dtilchin/PossumCtrl/hardware/ableton controller.kicad_pcb

## KiCad design hardware/ableton controller.kicad_pcb (2021-08-29)

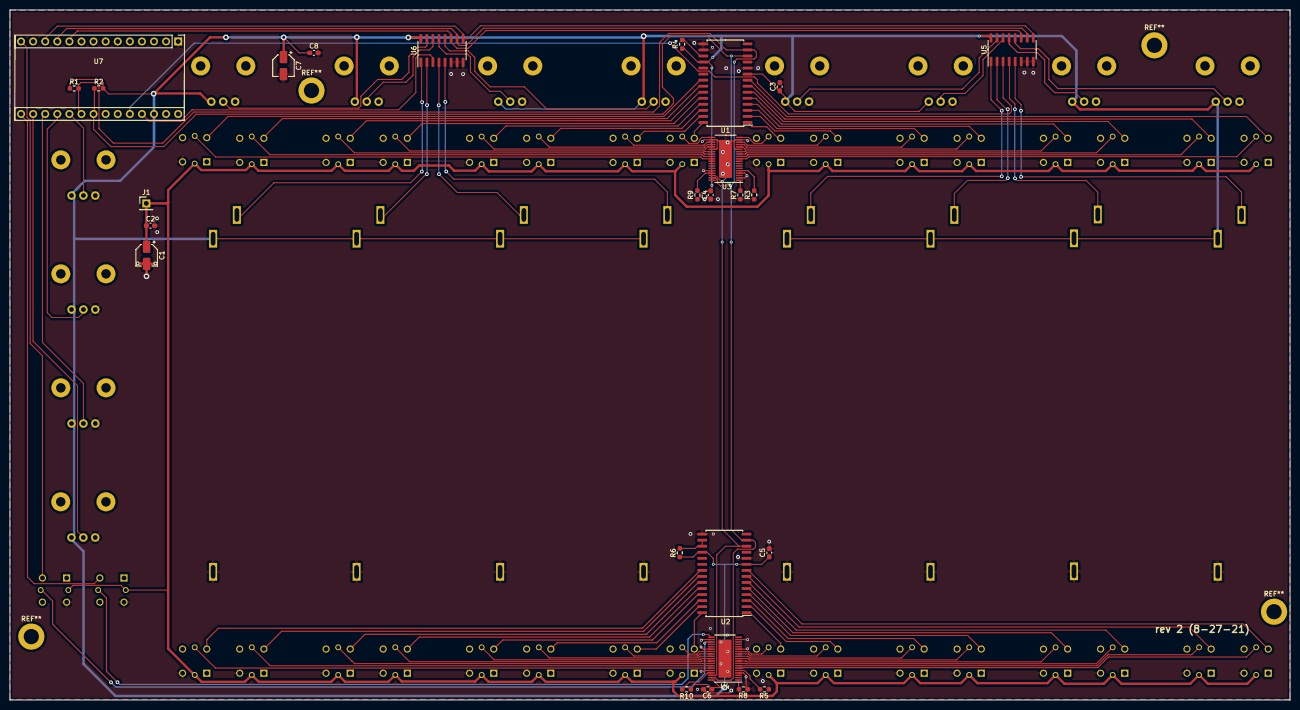
[picture p1: board ableton controller.kicad_pcb from above]

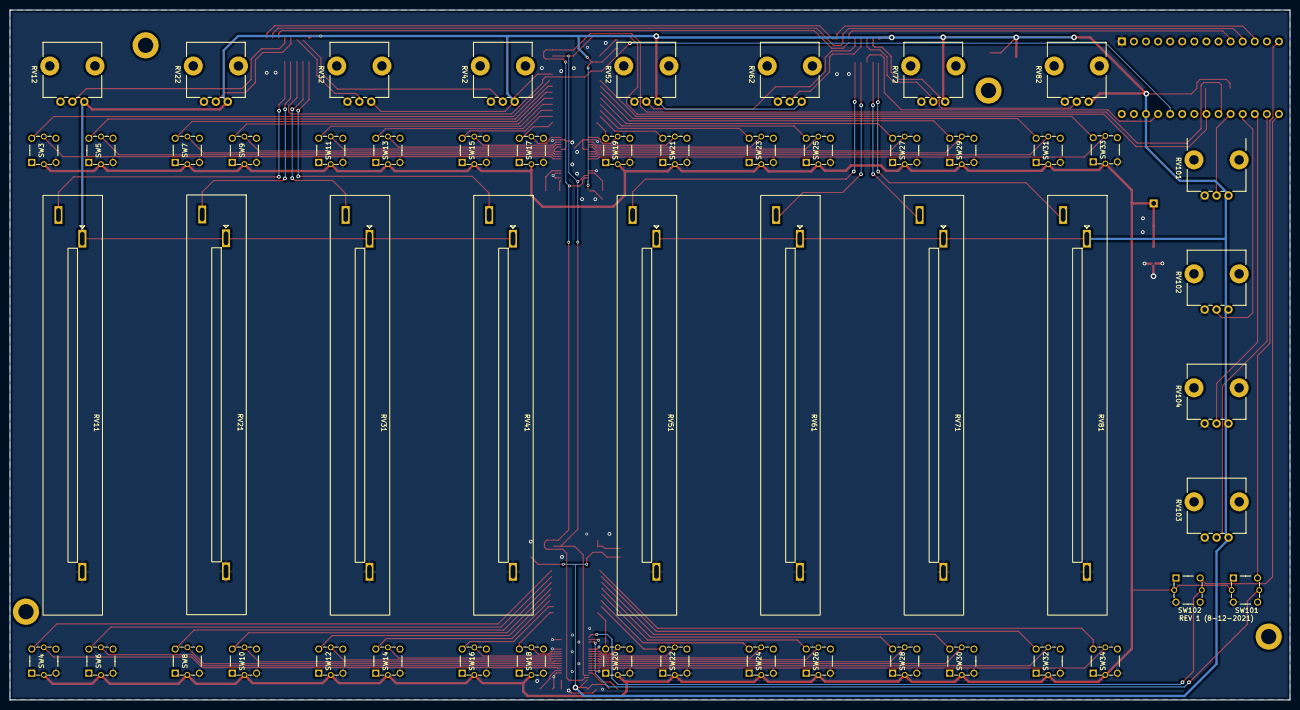
[picture p2: board ableton controller.kicad_pcb from below]

Board: 2 copper layers, 269.0 x 145.0 mm, 80 parts (54 on the bottom side), 106 nets.

Parts:
C1, C7: 10u; CP_Elec_4x4.5
C2, C3, C4, C5, C6, C8: 100n; C_0603_1608Metric_Pad1.08x0.95mm_HandSolder
J1: USB_header; PinHeader_1x01_P2.54mm_Vertical
R1, R2: 2k; R_0603_1608Metric_Pad0.98x0.95mm_HandSolder
R3, R4, R5, R6, R9, R10: 10k; R_0603_1608Metric_Pad0.98x0.95mm_HandSolder
R7, R8: 1k; R_0603_1608Metric_Pad0.98x0.95mm_HandSolder
RV11, RV21, RV31, RV41, RV51, RV61, RV71, RV81: R_gain; pot_slide_alpha_RA6020F
RV12, RV22, RV32, RV42, RV52, RV62, RV72, RV82: R_fx; Potentiometer_TaydaRV9312_Alpha901F_AlpsRK09L
RV101: R_fx_1; Potentiometer_TaydaRV9312_Alpha901F_AlpsRK09L
RV102: R_fx_2; Potentiometer_TaydaRV9312_Alpha901F_AlpsRK09L
RV103: R_fx_3; Potentiometer_TaydaRV9312_Alpha901F_AlpsRK09L
RV104: R_fx_4; Potentiometer_TaydaRV9312_Alpha901F_AlpsRK09L
SW3, SW7, SW11, SW15, SW19, SW23, SW27, SW31: SW_mute; Switch_button_LED_SPST_TS5_9.2mm
SW4, SW8, SW12, SW16, SW20, SW24, SW28, SW32: SW_play; Switch_button_LED_SPST_TS5_9.2mm
SW5, SW9, SW13, SW17, SW21, SW25, SW29, SW33: SW_solo; Switch_button_LED_SPST_TS5_9.2mm
SW6, SW10, SW14, SW18, SW22, SW26, SW30, SW34: SW_rec; Switch_button_LED_SPST_TS5_9.2mm
SW101: SW_m_rec; Switch_button_LED_SPST_TS5_9.2mm
SW102: SW_m_play; Switch_button_LED_SPST_TS5_9.2mm
U1, U2: MCP23017_SO; SOIC-28W_7.5x17.9mm_P1.27mm
U3, U4: PCA9956BTWY; TSSOP-38_4.4x9.7mm_P0.5mm_thermal39p
U5, U6: CD4051B; SOIC-16_3.9x9.9mm_P1.27mm
U7: Teensy-LC_sidepins; Teensy40_headers

Connections:
+5V: C1.1, C2.1, J1.1, SW3.6, SW4.6, SW5.6, SW6.6, SW7.6, SW8.6, SW9.6, SW10.6, SW11.6, SW12.6, SW13.6, SW14.6, SW15.6, SW16.6, SW17.6, SW18.6, SW19.6, SW20.6, SW21.6, SW22.6, SW23.6, SW24.6, SW25.6, SW26.6, SW27.6, SW28.6, SW29.6, SW30.6, SW31.6, SW32.6, SW33.6, SW34.6, SW101.6, SW102.6
/ADC0: U5.3 (X), U7.24 (22_A8_SCL1_PWM_Touch)
/ADC1: U6.3 (X), U7.25 (23_A9_SDA1_PWM_Touch)
/LED_MUTE_1: SW3.5, U3.10 (LED4)
/LED_MUTE_2: SW7.5, U3.12 (LED6)
/LED_MUTE_3: SW11.5, U3.15 (LED8)
/LED_MUTE_4: SW15.5, U3.17 (LED10)
/LED_MUTE_5: SW19.5, U3.20 (LED12)
/LED_MUTE_6: SW23.5, U3.23 (LED14)
/LED_MUTE_7: SW27.5, U3.26 (LED16)
/LED_MUTE_8: SW31.5, U3.28 (LED18)
/LED_PLAY: SW102.5, U4.20 (LED12)
/LED_PLAY_1: SW4.5, U4.6 (LED0)
/LED_PLAY_2: SW8.5, U4.8 (LED2)
/LED_PLAY_3: SW12.5, U4.10 (LED4)
/LED_PLAY_4: SW16.5, U4.12 (LED6)
/LED_PLAY_5: SW20.5, U4.26 (LED16)
/LED_PLAY_6: SW24.5, U4.28 (LED18)
/LED_PLAY_7: SW28.5, U4.30 (LED20)
/LED_PLAY_8: SW32.5, U4.32 (LED22)
/LED_REC: SW101.5, U4.22 (LED13)
/LED_REC_1: SW6.5, U4.7 (LED1)
/LED_REC_2: SW10.5, U4.9 (LED3)
/LED_REC_3: SW14.5, U4.11 (LED5)
/LED_REC_4: SW18.5, U4.13 (LED7)
/LED_REC_5: SW22.5, U4.27 (LED17)
/LED_REC_6: SW26.5, U4.29 (LED19)
/LED_REC_7: SW30.5, U4.31 (LED21)
/LED_REC_8: SW34.5, U4.33 (LED23)
/LED_SOLO_1: SW5.5, U3.11 (LED5)
/LED_SOLO_2: SW9.5, U3.13 (LED7)
/LED_SOLO_3: SW13.5, U3.16 (LED9)
/LED_SOLO_4: SW17.5, U3.19 (LED11)
/LED_SOLO_5: SW21.5, U3.22 (LED13)
/LED_SOLO_6: SW25.5, U3.24 (LED15)
/LED_SOLO_7: SW29.5, U3.27 (LED17)
/LED_SOLO_8: SW33.5, U3.29 (LED19)
/MUX_POT_A: U5.11 (A), U6.11 (A), U7.10 (8_TX3_MISO0)
/MUX_POT_B: U5.10 (B), U6.10 (B), U7.11 (9_RX2_PWM)
/MUX_POT_C: U5.9 (C), U6.9 (C), U7.12 (10_TX2_CS0_PWM)
/POT_FX_1: RV101.2, U7.19 (17_A3_SDA0_PWM_Touch)
/POT_FX_2: RV102.2, U7.18 (16_A2_SCL0_PWM_Touch)
/POT_FX_3: RV103.2, U7.16 (14_A0_SCK0)
/POT_FX_4: RV104.2, U7.17 (15_A1_Touch)
/POT_GAIN_1: RV11.2, U5.5 (X5)
/POT_GAIN_2: RV21.2, U5.4 (X7)
/POT_GAIN_3: RV31.2, U5.2 (X6)
/POT_GAIN_4: RV41.2, U5.1 (X4)
/POT_GAIN_5: RV51.2, U6.5 (X5)
/POT_GAIN_6: RV61.2, U6.4 (X7)
/POT_GAIN_7: RV71.2, U6.2 (X6)
/POT_GAIN_8: RV81.2, U6.1 (X4)
/POT_UTIL_1: RV12.2, U5.12 (X3)
/POT_UTIL_2: RV22.2, U5.13 (X0)
/POT_UTIL_3: RV32.2, U5.14 (X1)
/POT_UTIL_4: RV42.2, U5.15 (X2)
/POT_UTIL_5: RV52.2, U6.12 (X3)
/POT_UTIL_6: RV62.2, U6.13 (X0)
/POT_UTIL_7: RV72.2, U6.14 (X1)
/POT_UTIL_8: RV82.2, U6.15 (X2)
/SCL: R2.2, U1.12 (SCK), U2.12 (SCK), U3.36 (SCL), U4.36 (SCL), U7.21 (19_A5_SCL0_Touch)
/SDA: R1.2, U1.13 (SDA), U2.13 (SDA), U3.37 (SDA), U4.37 (SDA), U7.20 (18_A4_SDA0_Touch)
/SW_MUTE_1: SW3.2, U1.8 (GPB7)
/SW_MUTE_2: SW7.2, U1.6 (GPB5)
/SW_MUTE_3: SW11.2, U1.4 (GPB3)
/SW_MUTE_4: SW15.2, U1.2 (GPB1)
/SW_MUTE_5: SW19.2, U1.28 (GPA7)
/SW_MUTE_6: SW23.2, U1.26 (GPA5)
/SW_MUTE_7: SW27.2, U1.24 (GPA3)
/SW_MUTE_8: SW31.2, U1.22 (GPA1)
/SW_PLAY: SW102.2, U7.15 (13_LED_SCK0)
/SW_PLAY_1: SW4.2, U2.8 (GPB7)
/SW_PLAY_2: SW8.2, U2.6 (GPB5)
/SW_PLAY_3: SW12.2, U2.4 (GPB3)
/SW_PLAY_4: SW16.2, U2.2 (GPB1)
/SW_PLAY_5: SW20.2, U2.28 (GPA7)
/SW_PLAY_6: SW24.2, U2.26 (GPA5)
/SW_PLAY_7: SW28.2, U2.24 (GPA3)
/SW_PLAY_8: SW32.2, U2.22 (GPA1)
/SW_REC: SW101.2, U7.14 (12_MISO0)
/SW_REC_1: SW6.2, U2.7 (GPB6)
/SW_REC_2: SW10.2, U2.5 (GPB4)
/SW_REC_3: SW14.2, U2.3 (GPB2)
/SW_REC_4: SW18.2, U2.1 (GPB0)
/SW_REC_5: SW22.2, U2.27 (GPA6)
/SW_REC_6: SW26.2, U2.25 (GPA4)
/SW_REC_7: SW30.2, U2.23 (GPA2)
/SW_REC_8: SW34.2, U2.21 (GPA0)
/SW_SOLO_1: SW5.2, U1.7 (GPB6)
/SW_SOLO_2: SW9.2, U1.5 (GPB4)
/SW_SOLO_3: SW13.2, U1.3 (GPB2)
/SW_SOLO_4: SW17.2, U1.1 (GPB0)
/SW_SOLO_5: SW21.2, U1.27 (GPA6)
/SW_SOLO_6: SW25.2, U1.25 (GPA4)
/SW_SOLO_7: SW29.2, U1.23 (GPA2)
/SW_SOLO_8: SW33.2, U1.21 (GPA0)
GND: C1.2, C2.2, C3.2, C4.2, C5.2, C6.2, C7.2, C8.2, R3.2, R5.2, R7.2, R8.2, RV11.3, RV12.3, RV21.3, RV22.3, RV31.3, RV32.3, RV41.3, RV42.3, RV51.3, RV52.3, RV61.3, RV62.3, RV71.3, RV72.3, RV81.3, RV82.3, RV101.3, RV102.3, RV103.3, RV104.3, SW3.3, SW4.3, SW5.3, SW6.3, SW7.3, SW8.3, SW9.3, SW10.3, SW11.3, SW12.3, SW13.3, SW14.3, SW15.3, SW16.3, SW17.3, SW18.3, SW19.3, SW20.3, SW21.3, SW22.3, SW23.3, SW24.3, SW25.3, SW26.3, SW27.3, SW28.3, SW29.3, SW30.3, SW31.3, SW32.3, SW33.3, SW34.3, SW101.3, SW102.3, U1.10 (VSS), U1.15 (A0), U1.16 (A1), U2.10 (VSS), U2.15 (A0), U3.2 (AD0), U3.4 (AD2), U3.14 (VSS), U3.18 (VSS), U3.21 (VSS), U3.25 (VSS), U3.34 (VSS), U3.39 (EXP), U4.4 (AD2), U4.14 (VSS), U4.18 (VSS), U4.21 (VSS), U4.25 (VSS), U4.34 (VSS), U4.39 (EXP), U5.6 (INH), U5.7 (VEE), U5.8 (VSS), U6.6 (INH), U6.7 (VEE), U6.8 (VSS), U7.1 (GND)
unnamed: R3.1, U3.5 (~OE)
unnamed: R4.2, U1.17 (A2)
unnamed: R5.1, U4.5 (~OE)
unnamed: R6.2, U2.16 (A1), U2.17 (A2)
unnamed: R7.1, U3.1 (REXT)
unnamed: R8.1, U4.1 (REXT)
unnamed: R9.2, U3.35 (~RESET)
unnamed: R10.2, U4.35 (~RESET)
VCC: C3.1, C4.1, C5.1, C6.1, C7.1, C8.1, R1.1, R2.1, R4.1, R6.1, R9.1, R10.1, RV11.1, RV12.1, RV21.1, RV22.1, RV31.1, RV32.1, RV41.1, RV42.1, RV51.1, RV52.1, RV61.1, RV62.1, RV71.1, RV72.1, RV81.1, RV82.1, RV101.1, RV102.1, RV103.1, RV104.1, U1.9 (VDD), U1.18 (~RESET~), U2.9 (VDD), U2.18 (~RESET~), U3.38 (VDD), U4.38 (VDD), U5.16 (VDD), U6.16 (VDD), U7.26 (3.3V)
