dtilchin/PossumCtrl/(commit log)

2021-08-27 Initial commit. Works ok :)
    [ableton controller.kicad_pcb, ableton controller.kicad_sch, channel.kicad_sch, panel.kicad_pcb]
2021-08-27 PCB: Rev2. REXT and RESET pullups. 5v caps. Rerouting/cleanup.
    [ableton controller.kicad_pcb, ableton controller.kicad_sch, channel.kicad_sch]
2021-08-28 Disabled LEDs based on track count
    + misc things such as adjusting the current
2021-08-29 PCB: New panel, layout cleanup, maybe some fixes too?
    [ableton controller.kicad_pcb, ableton controller.kicad_sch, panel.kicad_pcb]
2021-09-01 LED brightness varies by color
2021-10-04 PCB: Tweaks? Fixes?
    [ableton controller.kicad_sch, channel.kicad_sch]
